shihab7269/Advanced-AC-AC-Power-Converter/four_switch_12.5_hz.ino

int transformer_voltage = 0;
int dummy = 0;

const int high_delay = 8000, low_delay = 1750;
const int T1 = 2, T2 = 3, T3 = 4, T4 = 5;

void setup() {
  Serial.begin(250000);
  pinMode(7, INPUT_PULLUP);
  
  pinMode(T1, OUTPUT);
  pinMode(T2, OUTPUT);
  pinMode(T3, OUTPUT);
  pinMode(T4, OUTPUT);
}

void loop() {
    transformer_voltage = digitalRead(7);
    //Serial.println(transformer_voltage);
    zerocross(); 
}

void zerocross()
{
  if(transformer_voltage == 0 && dummy == 0)
    {
      //Rising Edge......
      digitalWrite(T2, HIGH);
      delayMicroseconds(high_delay);
      digitalWrite(T2, LOW);
      delayMicroseconds(low_delay);
      digitalWrite(T1, HIGH);
      delayMicroseconds(high_delay);
      digitalWrite(T1, LOW);
      delayMicroseconds(low_delay);
      digitalWrite(T1, HIGH);
      delayMicroseconds(high_delay);
      digitalWrite(T1, LOW);
      delayMicroseconds(low_delay);
      digitalWrite(T2, HIGH);
      delayMicroseconds(high_delay);
      digitalWrite(T2, LOW);
      delayMicroseconds(low_delay);

      
      digitalWrite(T3, HIGH);
      delayMicroseconds(high_delay);
      digitalWrite(T3, LOW);
      delayMicroseconds(low_delay);
      digitalWrite(T4, HIGH);
      delayMicroseconds(high_delay);
      digitalWrite(T4, LOW);
      delayMicroseconds(low_delay);
      digitalWrite(T4, HIGH);
      delayMicroseconds(high_delay);
      digitalWrite(T4, LOW);
      delayMicroseconds(low_delay);
      digitalWrite(T3, HIGH);
      delayMicroseconds(high_delay);
      digitalWrite(T3, LOW);
      delayMicroseconds(low_delay);
      
      dummy = 1;
    }
    
    if(transformer_voltage == 1 && dummy == 1)
    {
     //Falling Edge......
      dummy = 0;
    }
}
